wJunYang0216/Mag-4/README.md

# Mag-4

ECE 455 final project: a proton-precession magnetometer.

## Project files

- [Polarization driver](polarization-driver/): PCB designs, previous KiCad versions, LTspice simulations, and driver notes.

Other team members can add their subsystem folders here.
