wJunYang0216/Mag-4/polarization-driver/firmware/README.md

# Firmware

NUCLEO-F446RE firmware will go here. No source code has been added yet.

See the [Rev I notes](../hardware/pcb/rev-i/RELEASE_NOTES.md) for pin assignments and the required switching sequence.
