wJunYang0216/Mag-4/polarization-driver/hardware/mechanical/README.md

# Mechanical files

No mechanical CAD files have been added yet. The PCB files are in [../pcb/](../pcb/).
