wJunYang0216/Mag-4/polarization-driver/docs/project-overview.md

# Project notes

The coil is powered during polarization, then discharged before being connected to the receiver. The MCU controls the timing and reads the current sensor.

Rev I is the latest PCB. The included LTspice files are from Rev G. Firmware, receiver integration, and bench testing are still in progress.

See the Rev I release notes for connector wiring and switching requirements.
