wJunYang0216/Mag-4/polarization-driver/hardware/pcb/previous-versions/Polarization_AWG19/Polarization_AWG19.pdf

1 | 2 | 3 | 4 | 5 | 6 | 7 | 8
1 | 2 | 3 | 4 | 5 | 6 | 7 | 8

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
Size: A3 | Rev: DRAFT A | F Date:
KiCad E.D.A. 10.0.6 | Id: 1/1

# Title: AWG19 Polarization Driver + Current Sensor

# File: Polarization_AWG19.kicad_sch

# Sheet: /

## ECE 455 - Jun Yang

R2
22

+12V_REG

1 -12V 2 +3V3

3 GND

4 J1

### REGULATED SUPPLIES

C2

10n R6
100k

1

2 3 Q1

### IRF530 (S1)

C6
100n U2

1

2 3 Q4

### IRF9640 (S4)

C3

# 1u U1-8 R4

100k

R8
10k
IN1 1 | GND1 2
IN2 3 | GND2 4 | OUT2 | 5
VCC2 | 6 OUT1 | 7
VCC1 | 8 U1

# LTC1693-1 D1

### 43V TVS - TBD

R10
100

1

2 3 Q5
IRF530 (S5)TOP | 1 BOTTOM | 2 J2

### AWG19 COIL

C4

1u U1-6 | R9
0.05 | / 0.5W / 1% | C8

100n U4

C1

### 1u COUPLING D2 FAST DIODE - TBD R1

22 | C7

### 100n U2 C5

### 1u U3 R5

100k | RX_IN

1 GND

2 J4

### TO AMPLIFIER R7 10k DAMP

IN 1 | NC 2 | PHASE 3 | GND 4 | NC | 5 NC | 6 OUT | 7
VCC | 8 U3

### LTC1693-5

POL 1

TG 2 | RX 3
SH 4 | DP 5 | RESET 6

I_ADC

7

FF 8 GND

9

### 3V3_REF 10 J3 MCU (3.3V LOGIC) R3

2.2

IN1_/_RX 1 | D1 | 2

S1 3

VSS | 4 GND | 5
S4 6 | D4 | 7

IN4_/_RESET 8

IN3_/_DP 9 | D3 | 10

S3 11

FF | 12
VDD | 13
S2 14 | D2 | 15
IN2_/_SH 16 | U2

### ADG5412F

NC 1

IN+ 2

IN- 3 | GND | 4
VS | 5 REF2 6 | REF1 7 | OUT | 8 U4

### INA240A1PW

RX G1

SH

BOTTOM

SENSE_LOW | +12V G5 | GND | -12V

TOP

GND

BOTTOM

PRE CLAMP_MID

GND

GND +12V | GND

DR4

FF PRE RX_IN | FF+3V3

TOP

SENSE_LOW

G4

GND

+12V

TOP | +3V3

CLAMP_MID

CS_OUT +3V3 | GND
GND | +3V3 GND

SENSE_LOW

GND

DR5 +12V DR1 +12V | POL GND

CS_OUT

I_ADC

GND

G4

I_ADC

DR4 | GND

RX_IN

GND

+12V -12V

DR5 +12V

+3V3

G4

GND

GND

I_ADC

G5

TG

G5

RX GND

POL | POL

TG

DP

RESET GND

DR1

SH

# FFGND

+12V

+3V3 G1

SENSE_LOW

G1

BOTTOM

TOP

# PRE DP

DAMP

RESET RX_IN

DAMP

BOTTOM

GND | GND +12V

BOTTOM

+12V GND | GND | GND +12V | -12V

# AWG 19 PROTON MAGNETOMETER - POLARIZATION DRIVER + CURRENT MONITOR

Engineering draft. Named nets connect across blocks. Based on Koehler Revision 4 and the latest LTspice circuit. 1. POWER SWITCHES / EXTERNAL COIL / CLAMP

Coil: R=11.430016 ohm, L=25.92669 mH, 1928 turns. D1 cathode joins D2 cathode. Clamp ratings / exact parts TBD. 2. MOSFET GATE DRIVERS

POL=1 turns Q1/Q4 on. TG=1 turns Q5 on. MCU must enforce dead time. No hardware interlock included. Use regulated 12 V. Verify MCU VOH against driver VIH. 6. LOCAL SUPPLY BYPASS (PLACE AT IC PINS) | DRAFT: DO NOT FABRICATE Clamp parts, footprints, noise,

## startup defaults and interlock need review. Coil receiver

## residual ~10.87 mV remains. 4. POLARIZATION CURRENT SENSOR

Simulation sequence (ms): 5-25: polarization 25: turn off, discharge 25.1: TOP grounding 37: damping off 38.98: shunt off 39: receive on 40: input reset off

## 5. EXTERNAL INTERFACES

Kelvin sense across R9. I = (Vadc - Vzero) / 1 V/A. Vzero ~1.65 V; 1.008 A -> 2.658 V in nominal simulation. Measures polarization only. Clamp current bypasses R9.

## 3. RECEIVER ISOLATION / DAMPING

U2 source pins face protected nodes. Four channels, one IC. RX load belongs to external amplifier. Simulation-only 100k / 10p load and 1n coil parasitic are omitted.
