wJunYang0216/Mag-4/polarization-driver/hardware/pcb/rev-i/Schematic_RevI.pdf

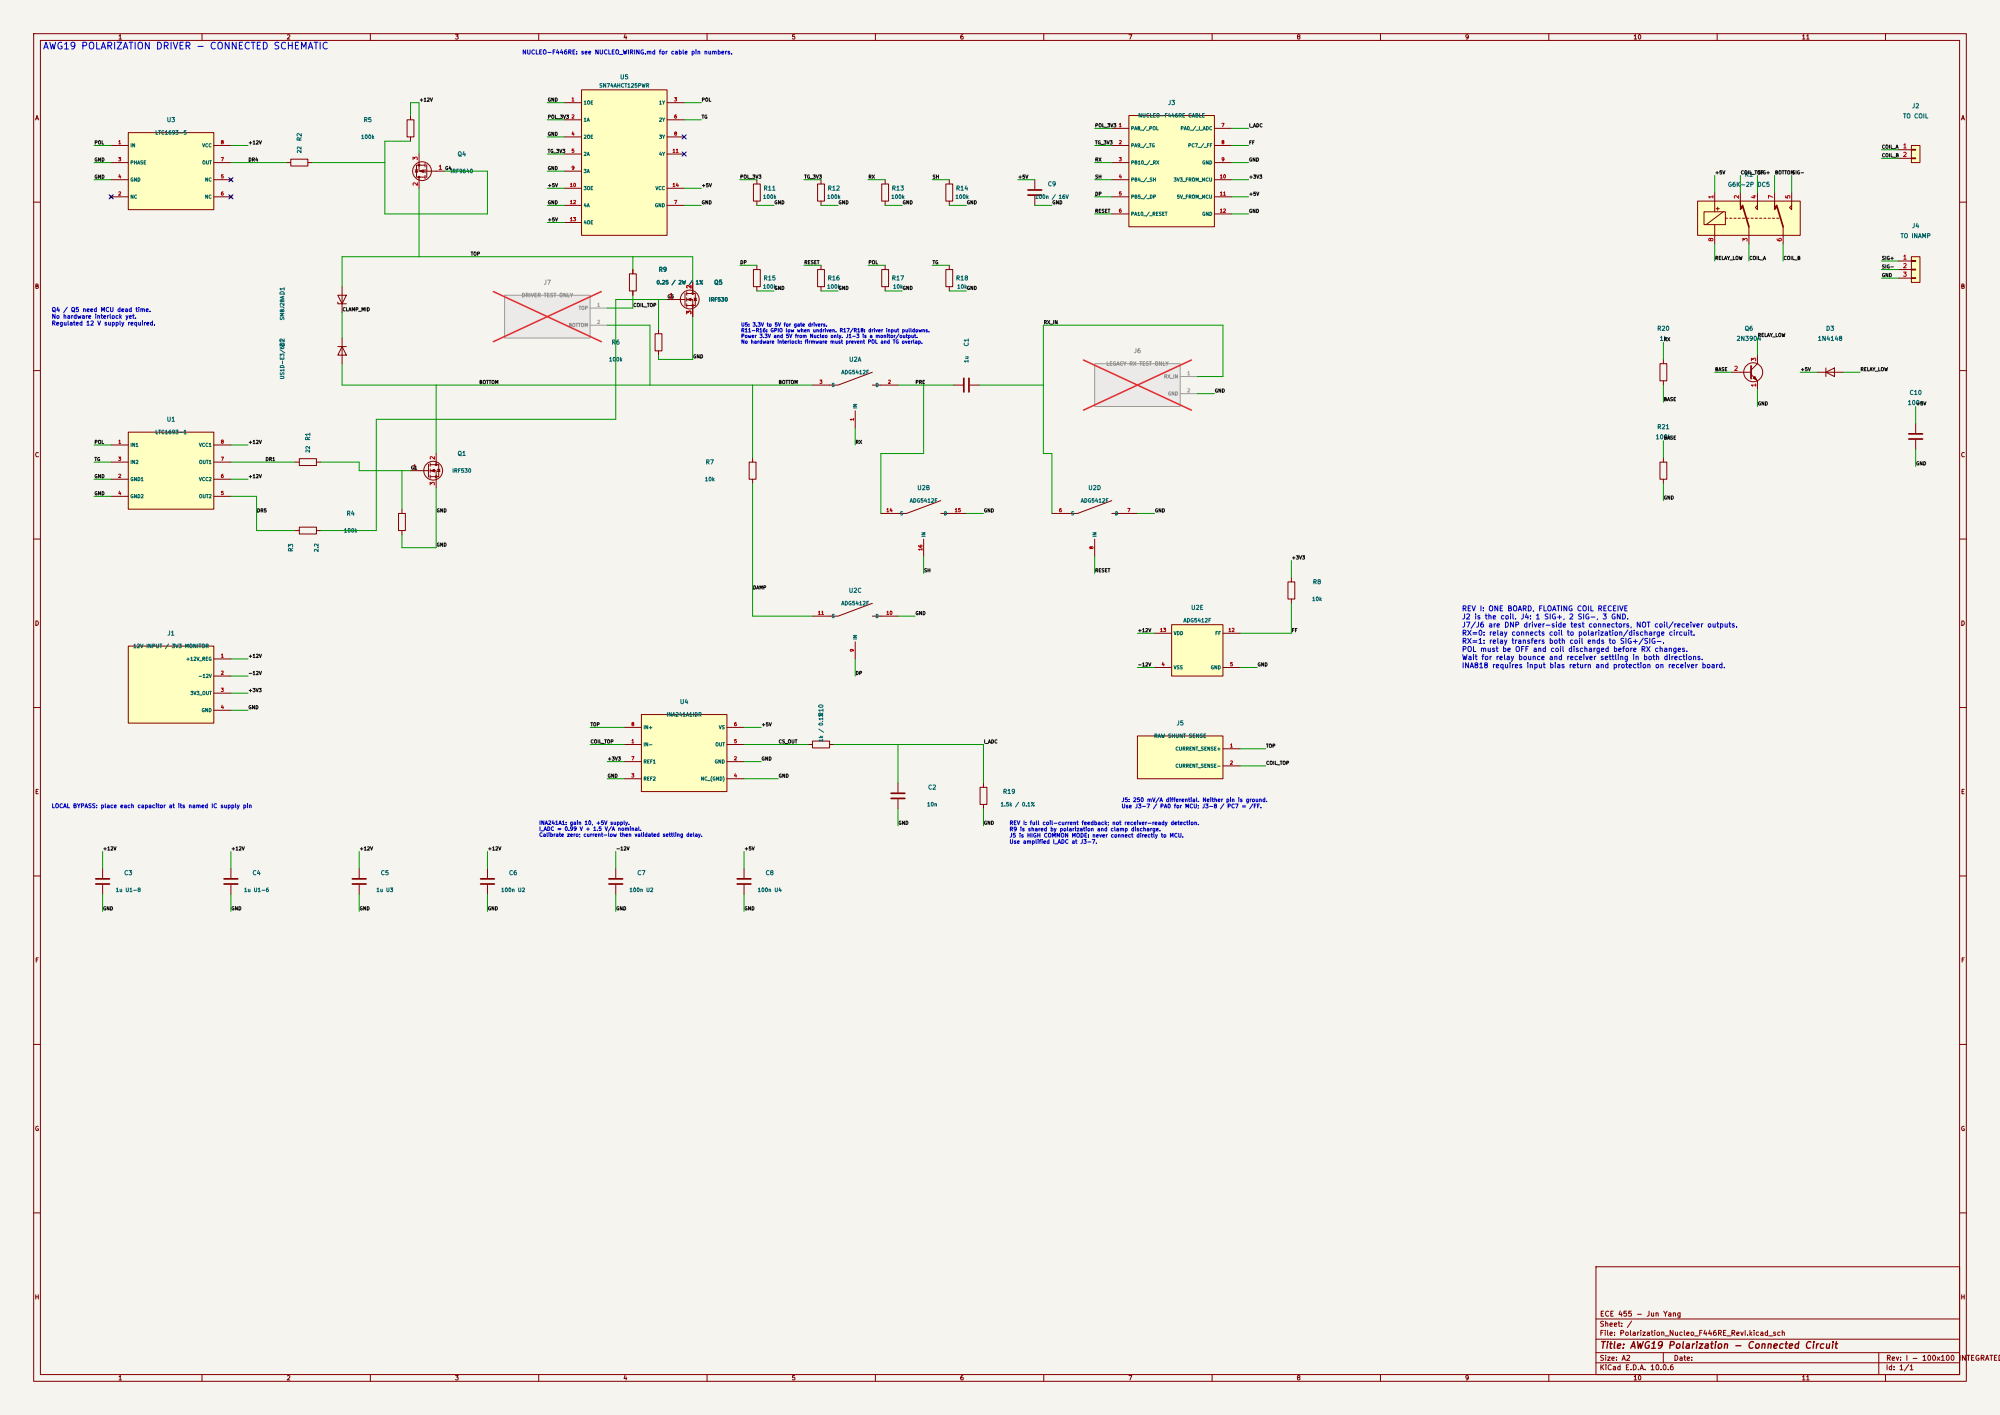
[picture p2: page 1]

AWG19 POLARIZATION DRIVER - CONNECTED SCHEMATIC

Q4 / Q5 need MCU dead time. No hardware interlock yet.

LEGACY RX TEST ONLY

J2 is the coil. J4: 1 SIG+, 2 SIG-, 3 GND.
J7/J6 are DNP driver-side test connectors, NOT coil/receiver outputs.
RX=0: relay connects coil to polarization/discharge circuit.
RX=1: relay transfers both coil ends to SIG+/SIG-.
POL must be OFF and coil discharged before RX changes.
Wait for relay bounce and receiver settling in both directions.
INA818 requires input bias return and protection on receiver board.

LOCAL BYPASS: place each capacitor at its named IC supply pin
