wJunYang0216/Mag-4/polarization-driver/hardware/pcb/previous-versions/Polarization_AWG19_Connected/Polarization_AWG19_Connected.pdf

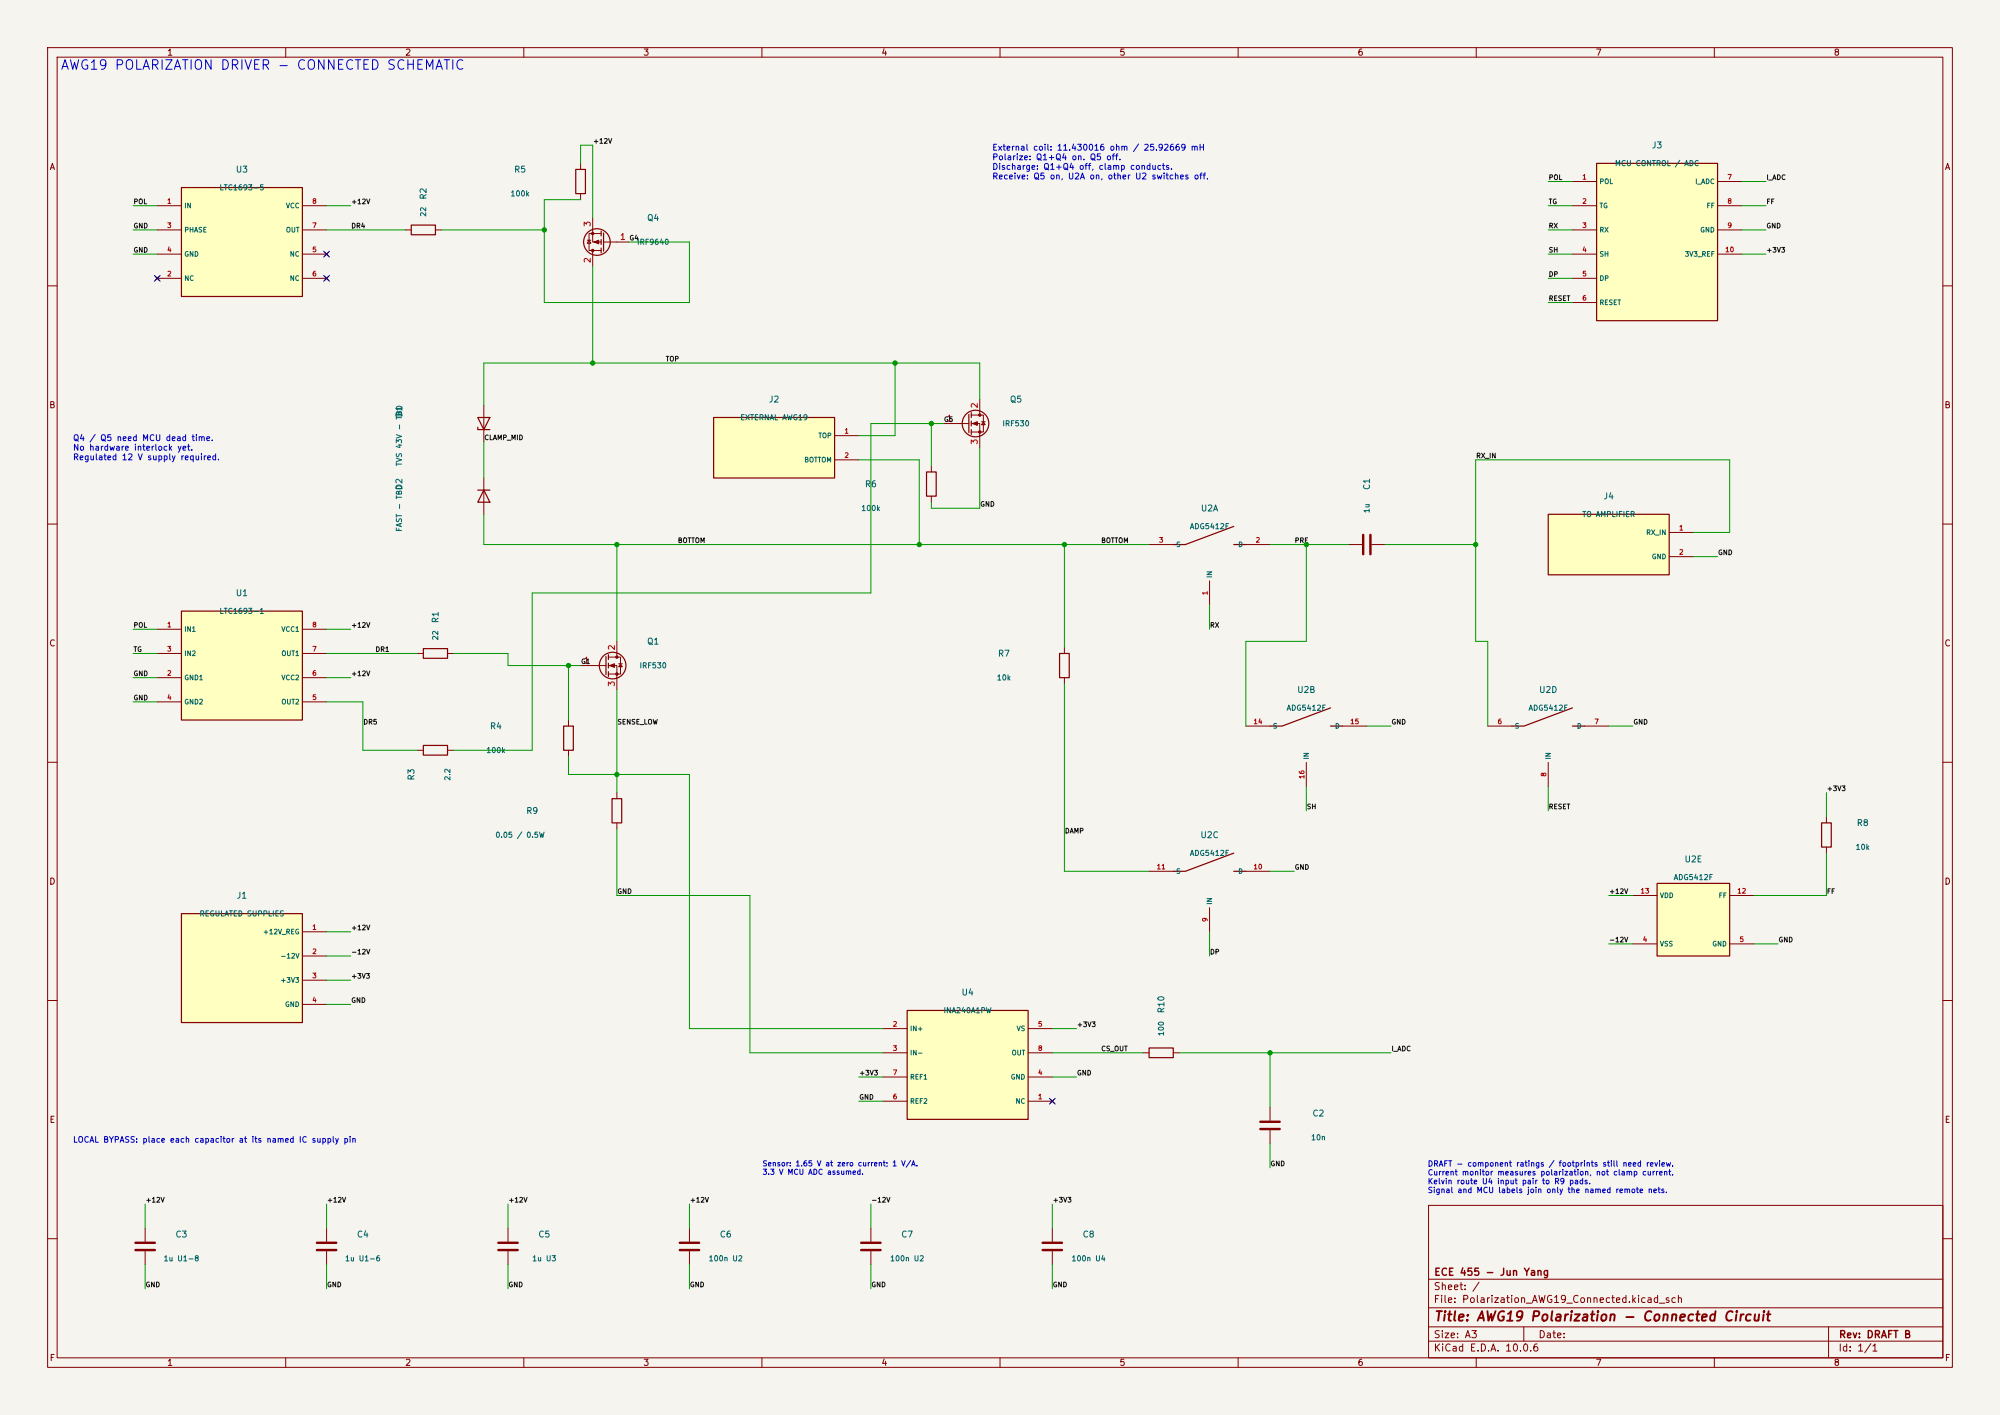
[picture p3: page 1]

AWG19 POLARIZATION DRIVER - CONNECTED SCHEMATIC

External coil: 11.430016 ohm / 25.92669 mH
Polarize: Q1+Q4 on. Q5 off. Discharge: Q1+Q4 off, clamp conducts. Receive: Q5 on, U2A on, other U2 switches off.

Signal and MCU labels join only the named remote nets. LOCAL BYPASS: place each capacitor at its named IC supply pin

Sensor: 1.65 V at zero current; 1 V/A. 3.3 V MCU ADC assumed.

DRAFT - component ratings / footprints still need review. Current monitor measures polarization, not clamp current. Kelvin route U4 input pair to R9 pads.

ECE 455 - Jun Yang
Sheet: /
File: Polarization_AWG19_Connected.kicad_sch
Title: AWG19 Polarization - Connected Circuit

Size: A3 | Rev: DRAFT B | F Date:
KiCad E.D.A. 10.0.6 | Id: 1/1
