wJunYang0216/Mag-4/polarization-driver/hardware/pcb/previous-versions/Polarization_Nucleo_F446RE_RevE/Polarization_Nucleo_F446RE_RevE.pdf

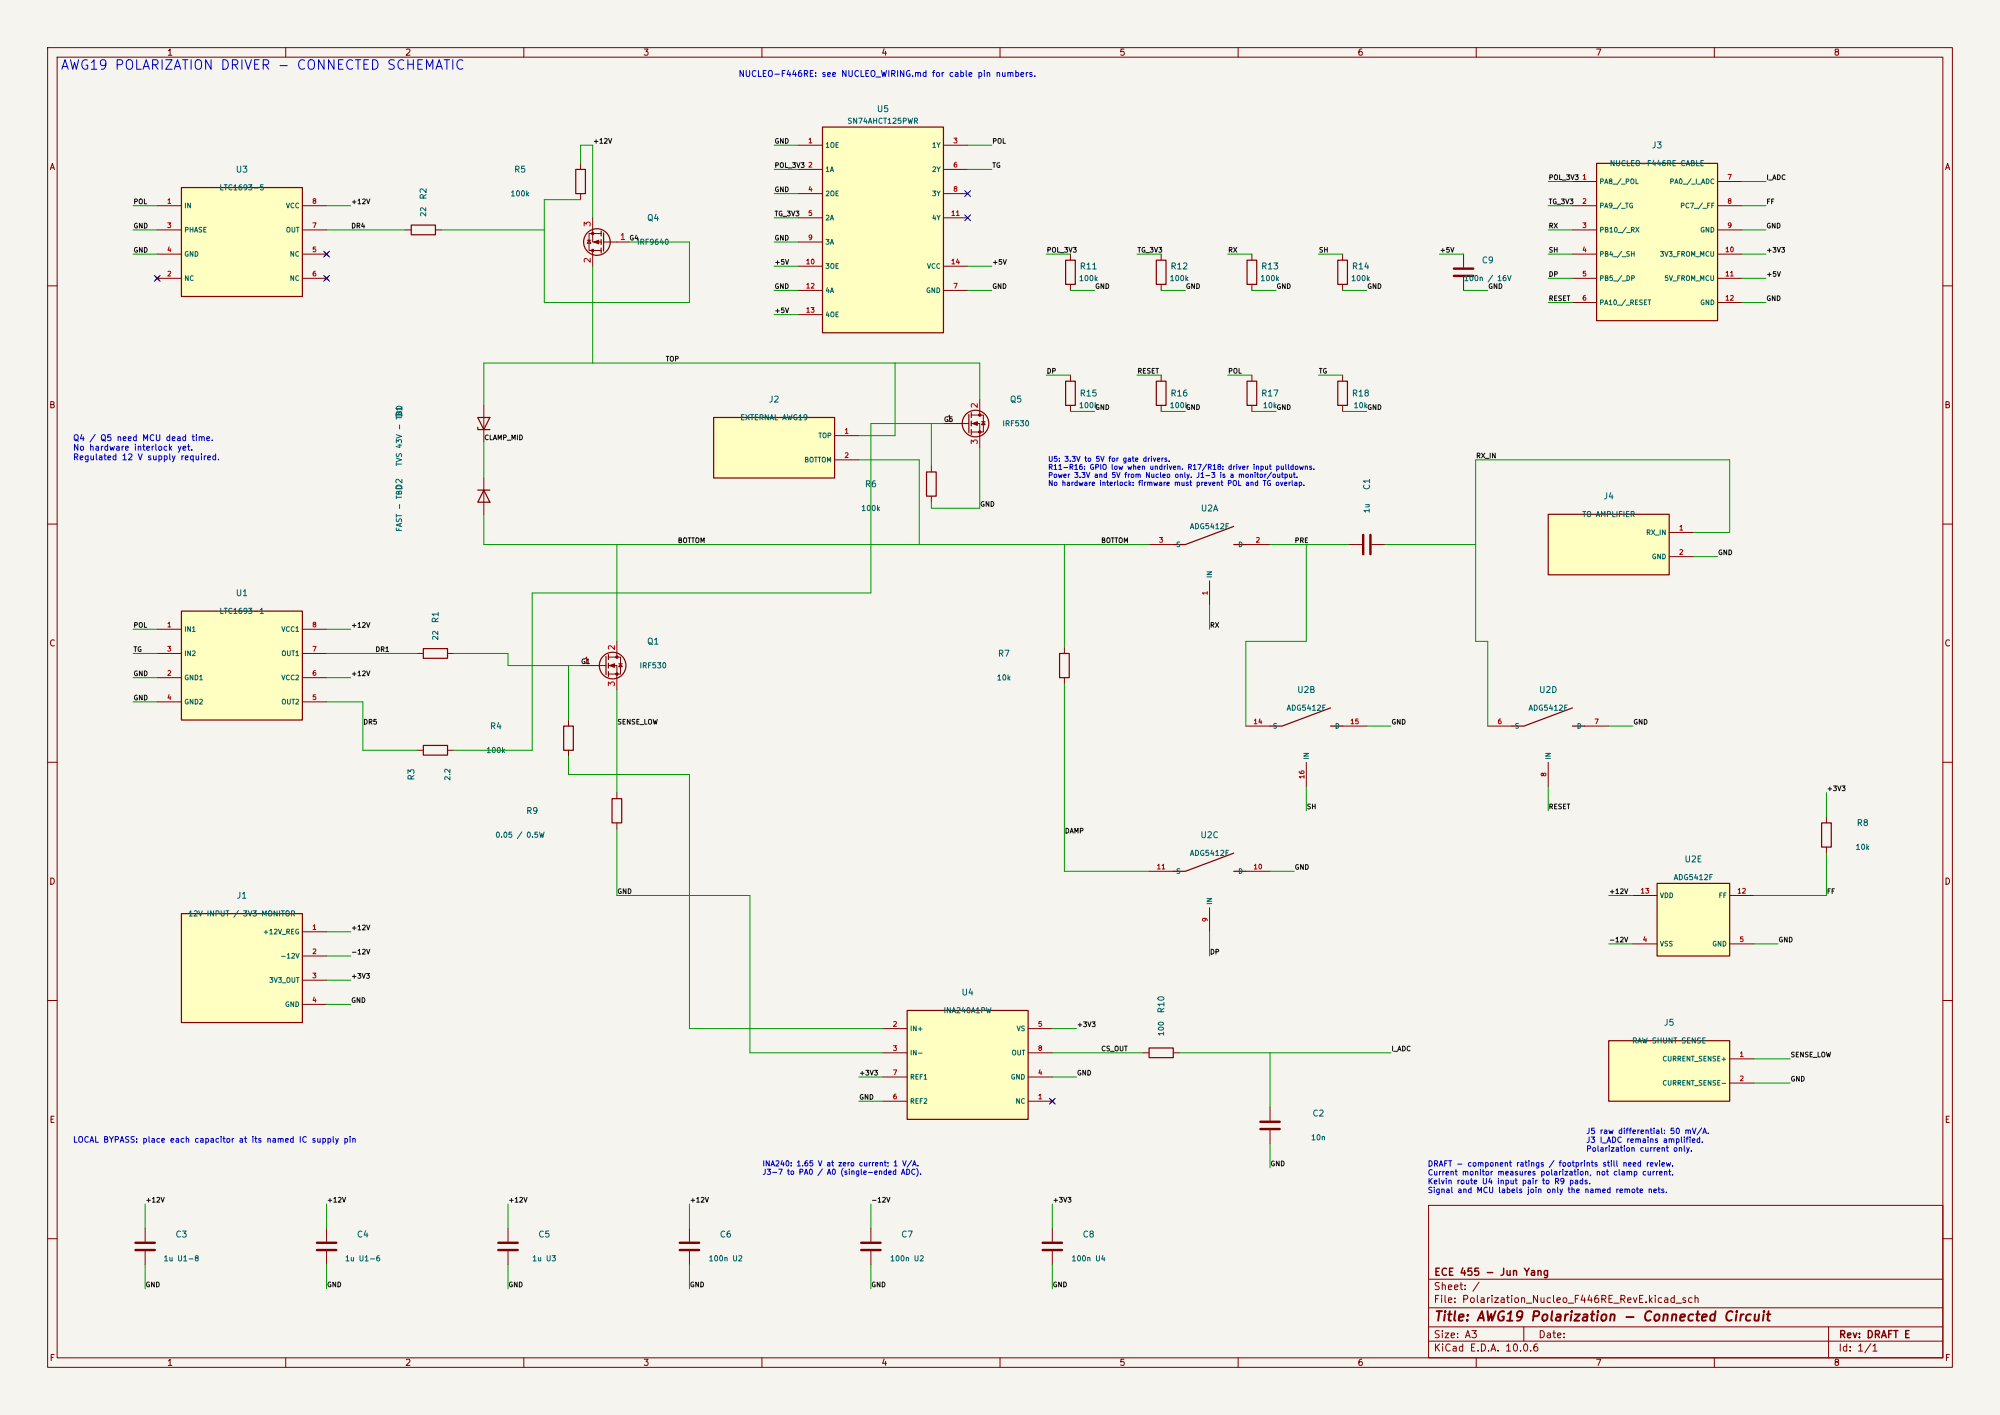
[picture p4: page 1]

SH AWG19 POLARIZATION DRIVER - CONNECTED SCHEMATIC

NUCLEO-F446RE: see NUCLEO_WIRING.md for cable pin numbers.

U5: 3.3V to 5V for gate drivers. R11-R16: GPIO low when undriven. R17/R18: driver input pulldowns. Power 3.3V and 5V from Nucleo only. J1-3 is a monitor/output. No hardware interlock: firmware must prevent POL and TG overlap. Q4 / Q5 need MCU dead time. No hardware interlock yet.

Signal and MCU labels join only the named remote nets. J5 raw differential: 50 mV/A. J3 I_ADC remains amplified. Polarization current only.

INA240: 1.65 V at zero current; 1 V/A. J3-7 to PA0 / A0 (single-ended ADC). LOCAL BYPASS: place each capacitor at its named IC supply pin

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

ECE 455 - Jun Yang
Sheet: /
File: Polarization_Nucleo_F446RE_RevE.kicad_sch
Title: AWG19 Polarization - Connected Circuit

Size: A3 | Rev: DRAFT E | F Date:
KiCad E.D.A. 10.0.6 | Id: 1/1
