wJunYang0216/Mag-4/polarization-driver/simulation/ltspice/rev-g/Koehler_AWG19_Newark_025R.asc

CADC: cap; 10n
CBYP: cap; 1u
CC: cap; 1u
CCS: cap; 100n
CINPUT: cap; 10p
CPAR: cap; {CP}
DFLY: diode; US1D_APPROX
DZ: zener; SMBJ28A_APPROX
LCOIL: ind; {LC}
M1: nmos; IRF530
M4: pmos; IRF9640
M5: nmos; IRF530
RADC: res; 1k
RADCLOAD: res; 1.5k
RCOIL: res; {RC}
RDAMP: res; {RD}
RFF: res; 10k
RG1: res; 22
RG4: res; 22
RG5: res; 2.2
RGS1: res; 100k
RGS4: res; 100k
RGS5: res; 100k
RINPUT: res; 100k
RSHUNT: res; 0.25
U1: LTC1693-1_local
U2A: ADG5412F_local
U2B: ADG5412F_local
U2C: ADG5412F_local
U2D: ADG5412F_local
U3: LTC1693-5_local
U4: INA241_local
VBAT: voltage; 12
VDD: voltage; 12
VLOG: voltage; 3.3
VSS: voltage; -12
Named nets: BOTTOM, G1, 0, TOP, G5, G4, VBAT, COIL_TOP, COILMID, CLAMP_MID, RX, PRE, VSS, VDD, FF, SH, DP, DAMP, RESET, RX_IN, POL, TG, DR5, DR1, DR4, VLOG, CS_OUT, V5, I_ADC
KOEHLER REAL-DEVICE FEASIBILITY TEST - alternative MOSFETs, not the original BOM
M1/M5: IRF530; M4: IRF9640; ADG5412F channels A-D; LTC1693 drivers
Named nets connect across blocks. SMBJ28A / US1D: datasheet-based APPROXIMATE models. Receiver is a placeholder.
POWER SWITCHES / COIL / CLAMP
RECEIVER SWITCHES: FOUR CHANNELS OF ONE ADG5412F
U2D resets RX_IN until 40 ms. Use the real amplifier model before hardware approval.
GATE DRIVERS - regulated 12 V bench supply, 3.3 V logic commands
SUPPLIES: VDD/VSS are ideal analog rails. Their physical supply circuit is not included.
CURRENT MONITOR: Rshunt=0.25 ohm / 2W; INA241A1 gain=10; ADC divider=0.6. Polarization AND discharge current.
I_ADC = about 0.99 V + 1.5 V/A. REF1=3.3 V, REF2=GND. MCU ADC assumed 3.3 V.
V5 V5 0 5
.param RC=11.430016 LC=25.92669m CP=1n RD=10k
VRESET RESET 0 PWL(0 3.3 40m 3.3 40.001m 0)
.include "vendor/selected_diodes.lib"
VPOL POL 0 PWL(0 0 5m 0 5.001m 5 25m 5 25.001m 0)
VTOP TG 0 PWL(0 5 4.9m 5 4.901m 0 25.1m 0 25.101m 5)
VDAMP DP 0 PWL(0 3.3 37m 3.3 37.001m 0)
VSHUNT SH 0 PWL(0 3.3 38.98m 3.3 38.981m 0)
VRX RX 0 PWL(0 0 39m 0 39.001m 3.3)
.options plotwinsize=0 method=gear
.tran 0 70m 0 100n
.save V(VBAT) V(TOP) V(BOTTOM) V(PRE) V(RX_IN) V(G1) V(G4) V(G5) I(LCOIL) I(VBAT) V(FF) I(M4) I(M1) I(M5)
.meas TRAN I_POL FIND I(LCOIL) AT=24m
.meas TRAN BOTTOM_MAX MAX V(BOTTOM)
.meas TRAN BOTTOM_MIN MIN V(BOTTOM)
.meas TRAN TOP_MIN MIN V(TOP)
.meas TRAN RX_BLANK MAX abs(V(RX_IN)) FROM 0 TO 38.98m
.meas TRAN RX_ACQ MAX abs(V(RX_IN)) FROM 60m TO 70m
.meas TRAN G1_MAX MAX V(G1)
.meas TRAN G4_MIN MIN V(G4,VBAT)
.meas TRAN G4_MAX MAX V(G4,VBAT)
.meas TRAN I_SUPPLY_MAX MAX (-I(VBAT))
.model IRF530 VDMOS(Rg=3 Vto=4 Rd=50m Rs=12m Rb=60m Kp=5 lambda=.01 Cgdmax=1n Cgdmin=.26n Cgs=.2n Cjo=.4n Is=52p ksubthres=.1 mfg=International_Rectifier Vds=100 Ron=160m Qg=26n)
.model IRF9640 VDMOS(pchan Rg=3 Vto=-3.5 Rd=.15 Rs=.15 Rb=.15 Kp=8 lambda=.01 mtriode=.5 Cgdmax=1.5n Cgdmin=.07n Cgs=1n Cjo=1n Is=38p ksubthres=.1 mfg=International_Rectifier Vds=-200 Ron=.5 Qg=44n)
.include "vendor/ina241_adapter.lib"
.save V(COIL_TOP) V(CS_OUT) V(I_ADC) V(VLOG) I(RSHUNT)
.meas TRAN ADC_24 FIND V(I_ADC) AT=24m
.meas TRAN SHUNT_24 FIND I(RSHUNT) AT=24m
.meas TRAN SHUNT_POWER_24 FIND (V(TOP,COIL_TOP)*I(RSHUNT)) AT=24m
