wJunYang0216/Mag-4/(commit log)

2026-10-30 Add initial project documentation and polarization driver design files
    [BOM_RevH.csv, BOM_RevI.csv, Newark_025R_trace.csv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]
2026-10-30 Simplify project notes and add previous KiCad versions
    [BOM_RevG.csv, BOM_RevH.csv, Floating_Coil_Relay_Adapter_DRAFT.kicad_pcb, Floating_Coil_Relay_Adapter_DRAFT.kicad_sch, Polarization_AWG19.kicad_sch, Polarization_AWG19_Connected.kicad_sch, Polarization_AWG19_PCB.kicad_pcb, Polarization_AWG19_PCB.kicad_sch]
2026-10-30 Group polarization driver files in their own subsystem folder
    [BOM_RevG.csv, BOM_RevH.csv, BOM_RevI.csv, Floating_Coil_Relay_Adapter_DRAFT.kicad_pcb, Floating_Coil_Relay_Adapter_DRAFT.kicad_sch, Newark_025R_trace.csv, Polarization_AWG19.kicad_sch, Polarization_AWG19_Connected.kicad_sch]
